shehabeldinkhalid-BioMedecailEng/IOT-C-M/hardware plan.jpeg

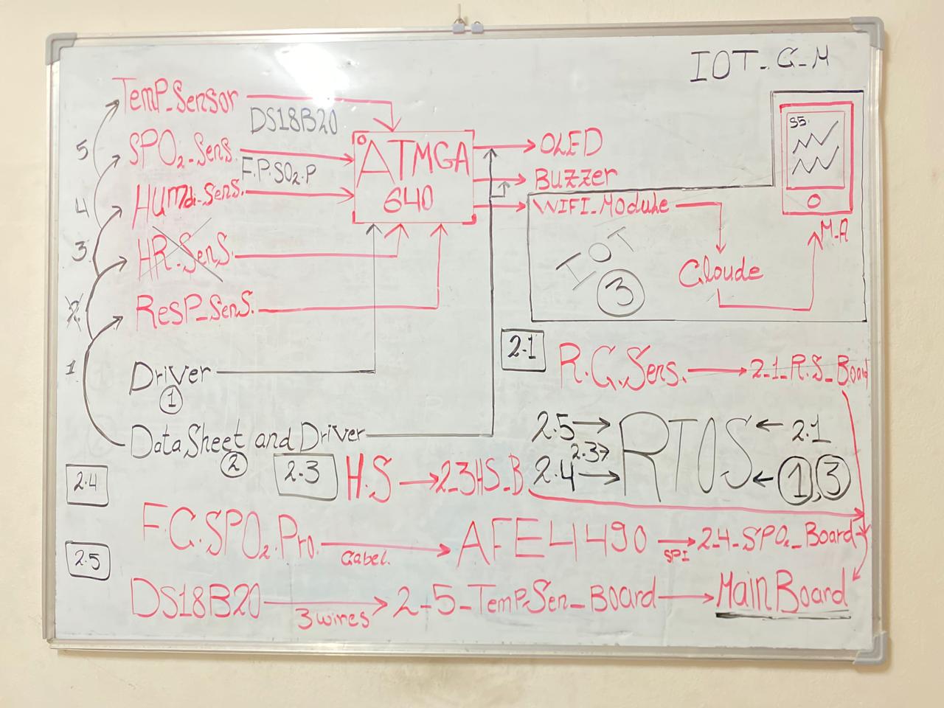
hardware plan.jpeg
