shehabeldinkhalid-BioMedecailEng/IOT-C-M/signal plan.jpeg

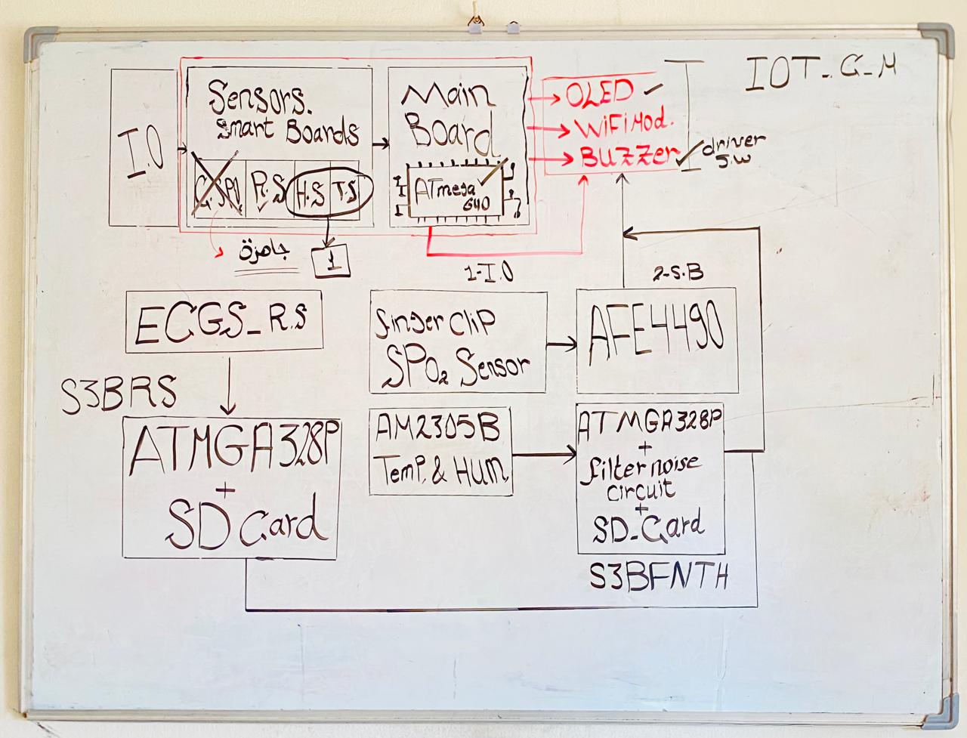
signal plan.jpeg
