shehabeldinkhalid-BioMedecailEng/IOT-C-M/code plan.jpeg

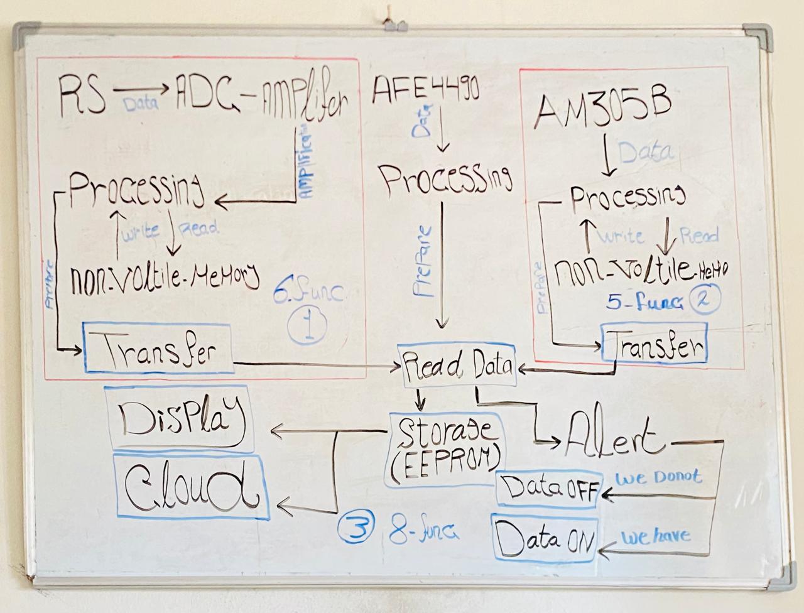
code plan.jpeg
