shehabeldinkhalid-BioMedecailEng/IOT-C-M/da705f88-b7d9-4b37-bf36-8e28f23b1218.webp

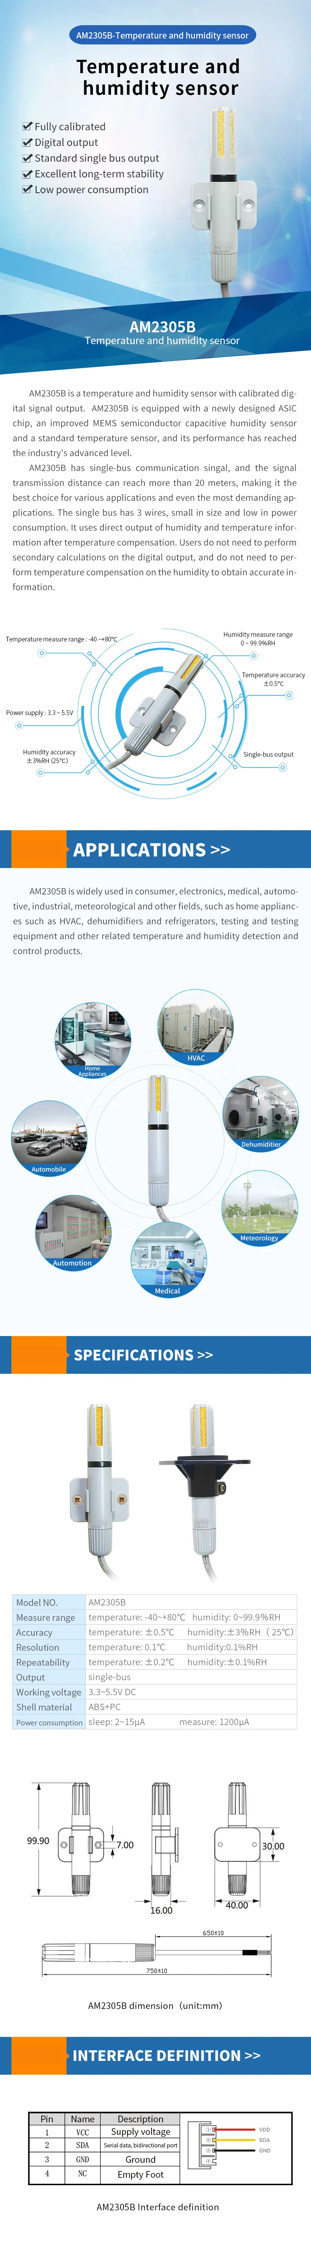
da705f88-b7d9-4b37-bf36-8e28f23b1218.webp
