shehabeldinkhalid-BioMedecailEng/IOT-C-M/Schematic_IOT_C_M_SMART-DEVICE_2026-09-08.pdf

# EX-CLK

## OLED-I2C

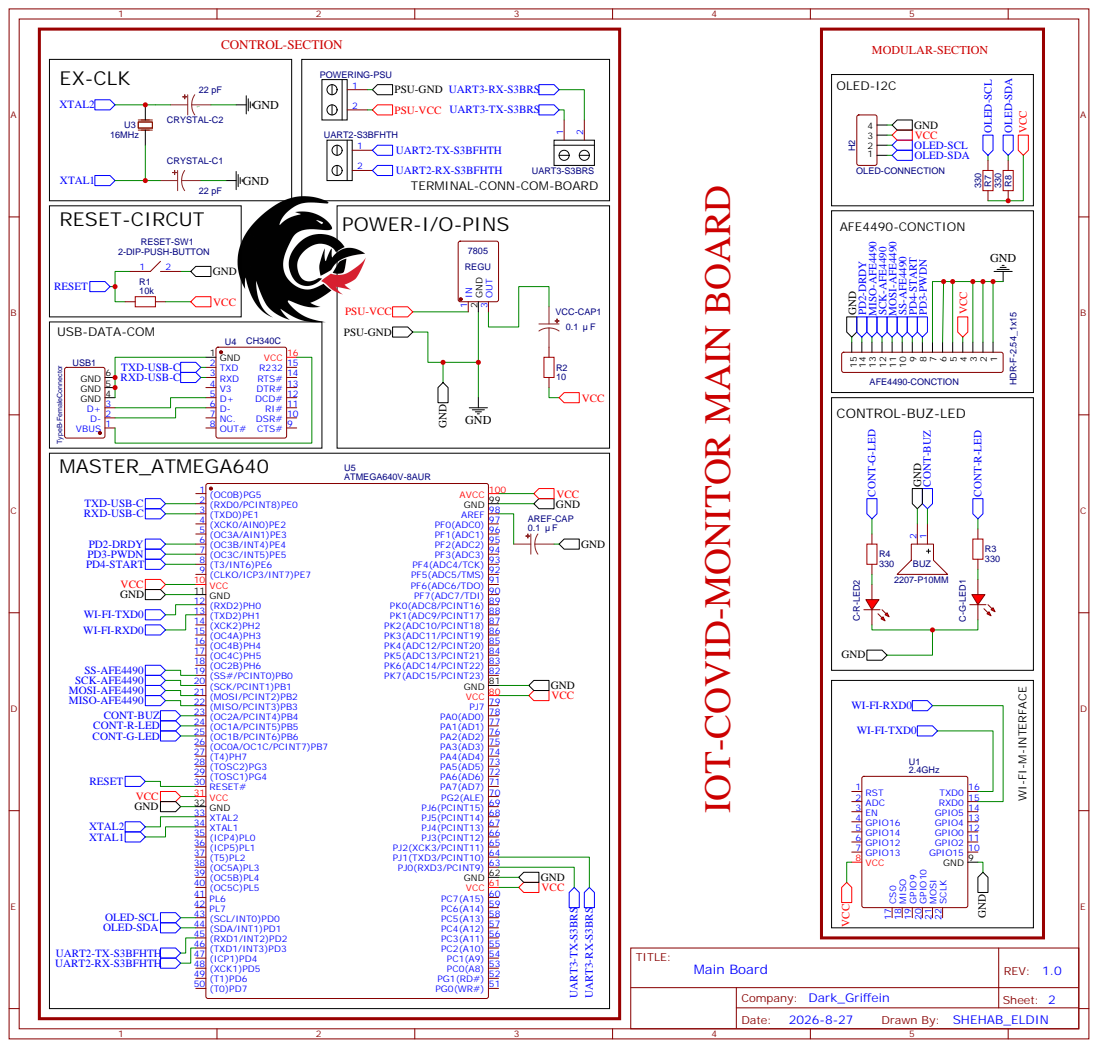
[picture p5: page 1]

UART2-TX-S3BFHTH
UART2-RX-S3BFHTH
TERMINAL-CONN-COM-BOARD
POWER-I/O-PINS

IOT-COVID-MONITOR MAIN BOARD

DSR# 10 RI# 11 DCD# 12 DTR# 13 RTS# 14 R232 15 VCC 16

Atemega328P-AM2305B | POWER-AM2305B

# DS CARD SD\C⁻GND SD\C⁻VCC SD⁻CARD⁻MISO SD⁻CARD⁻MOSI SD⁻CARD⁻SCK SD⁻CARD⁻CS

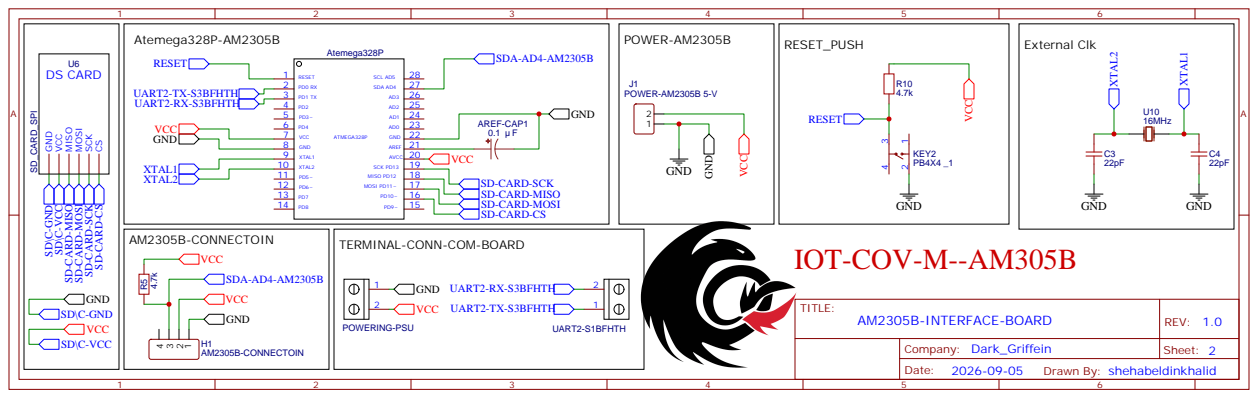
[picture p6: page 2]

TERMINAL-CONN-COM-BOARD

## HX711_IC/RS-INTERFACE BOARD

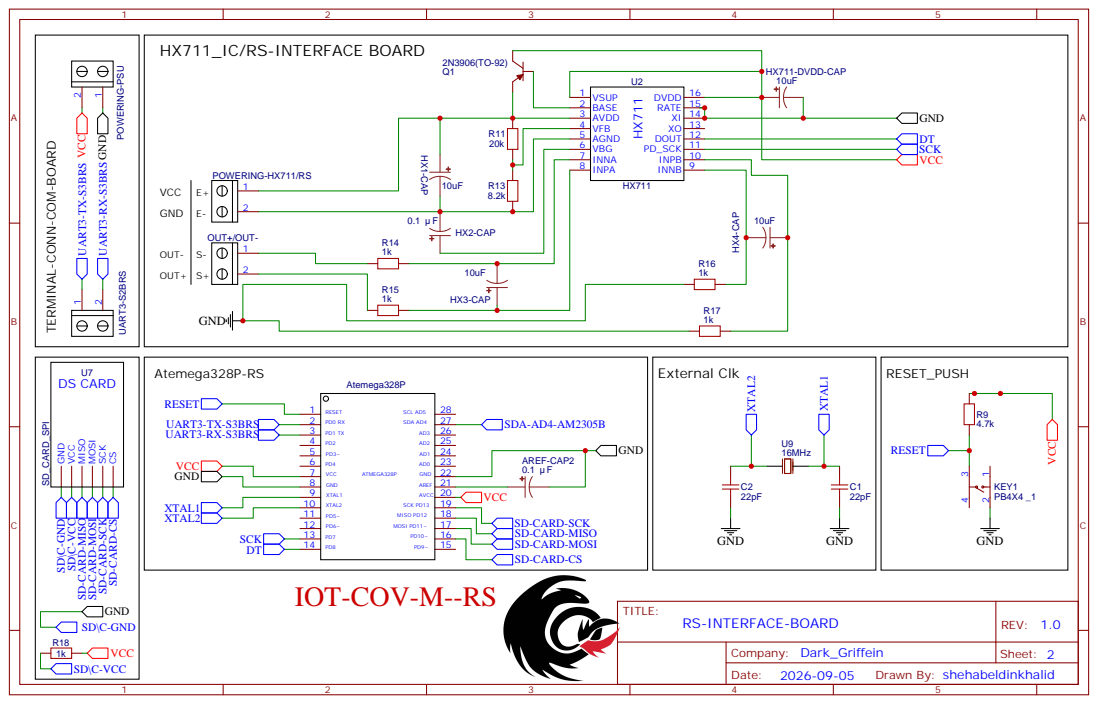
[picture p7: page 3]

INPB 10 PD_SCK 11 DOUT 12 XO 13 XI 14 RATE 15 DVDD 16

TERMINAL-CONN-COM-BOARD

SD\C-GND SD⁻CARD⁻CS SD⁻CARD⁻SCK SD⁻CARD⁻MISO SD⁻CARD⁻MOSI

# POWER SUPPLY

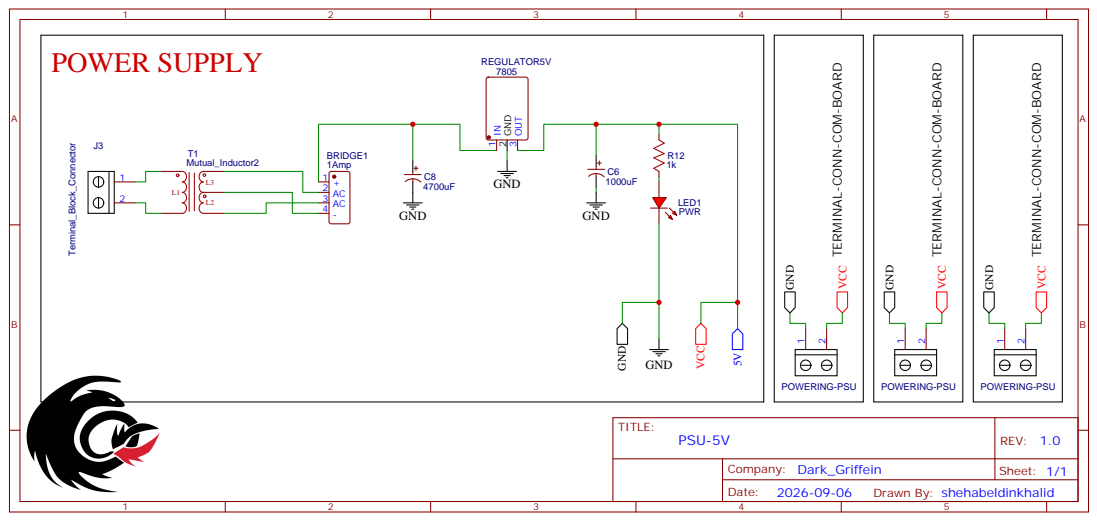
[picture p8: page 4]

TERMINAL-CONN-COM-BOARD

VCC TERMINAL-CONN-COM-BOARD
