shehabeldinkhalid-BioMedecailEng/IOT-C-M/(list of files, drawings)

Other design files:
IOT_C_M.pdsprj
