shehabeldinkhalid-BioMedecailEng/IOT-C-M/SW/ATMEGA640-DRIVERS/HAL/OLED_Config.h

#ifndef OLED_CONFIG_H_
#define OLED_CONFIG_H_

#define OLED_WIDTH              128
#define OLED_HEIGHT             64
#define OLED_PAGES              8

#define OLED_I2C_ADDRESS        0x78

#define OLED_CONTROL_COMMAND    0x00
#define OLED_CONTROL_DATA       0x40

#define OLED_COLUMN_OFFSET      0

#endif /* OLED_CONFIG_H_ */
