shehabeldinkhalid-BioMedecailEng/IOT-C-M/SW/ATMEGA640-DRIVERS/HAL/OLED_Font.c

#include "../../DataTypes.h"

#include "OLED_Font.h"


const OLED_FontChar_t OLED_Font[] =
{
	/* Space */
	{' ', {0x00, 0x00, 0x00, 0x00, 0x00}},

	/* A */
	{'A', {0x7E, 0x11, 0x11, 0x11, 0x7E}},

	/* B */
	{'B', {0x7F, 0x49, 0x49, 0x49, 0x36}},

	/* C */
	{'C', {0x3E, 0x41, 0x41, 0x41, 0x22}},

	/* D */
	{'D', {0x7F, 0x41, 0x41, 0x22, 0x1C}},

	/* E */
	{'E', {0x7F, 0x49, 0x49, 0x49, 0x41}},

	/* F */
	{'F', {0x7F, 0x09, 0x09, 0x09, 0x01}},

	/* G */
	{'G', {0x3E, 0x41, 0x49, 0x49, 0x7A}},

	/* H */
	{'H', {0x7F, 0x08, 0x08, 0x08, 0x7F}},

	/* I */
	{'I', {0x00, 0x41, 0x7F, 0x41, 0x00}},

	/* J */
	{'J', {0x20, 0x40, 0x41, 0x3F, 0x01}},

	/* K */
	{'K', {0x7F, 0x08, 0x14, 0x22, 0x41}},

	/* L */
	{'L', {0x7F, 0x40, 0x40, 0x40, 0x40}},

	/* M */
	{'M', {0x7F, 0x02, 0x0C, 0x02, 0x7F}},

	/* N */
	{'N', {0x7F, 0x04, 0x08, 0x10, 0x7F}},

	/* O */
	{'O', {0x3E, 0x41, 0x41, 0x41, 0x3E}},

	/* P */
	{'P', {0x7F, 0x09, 0x09, 0x09, 0x06}},

	/* Q */
	{'Q', {0x3E, 0x41, 0x51, 0x21, 0x5E}},

	/* R */
	{'R', {0x7F, 0x09, 0x19, 0x29, 0x46}},

	/* S */
	{'S', {0x46, 0x49, 0x49, 0x49, 0x31}},

	/* T */
	{'T', {0x01, 0x01, 0x7F, 0x01, 0x01}},

	/* U */
	{'U', {0x3F, 0x40, 0x40, 0x40, 0x3F}},

	/* V */
	{'V', {0x1F, 0x20, 0x40, 0x20, 0x1F}},

	/* W */
	{'W', {0x7F, 0x20, 0x18, 0x20, 0x7F}},

	/* X */
	{'X', {0x63, 0x14, 0x08, 0x14, 0x63}},

	/* Y */
	{'Y', {0x07, 0x08, 0x70, 0x08, 0x07}},

	/* Z */
	{'Z', {0x61, 0x51, 0x49, 0x45, 0x43}},

	/* 0 */
	{'0', {0x3E, 0x51, 0x49, 0x45, 0x3E}},

	/* 1 */
	{'1', {0x00, 0x42, 0x7F, 0x40, 0x00}},

	/* 2 */
	{'2', {0x62, 0x51, 0x49, 0x49, 0x46}},

	/* 3 */
	{'3', {0x22, 0x41, 0x49, 0x49, 0x36}},

	/* 4 */
	{'4', {0x18, 0x14, 0x12, 0x7F, 0x10}},

	/* 5 */
	{'5', {0x2F, 0x49, 0x49, 0x49, 0x31}},

	/* 6 */
	{'6', {0x3E, 0x49, 0x49, 0x49, 0x32}},

	/* 7 */
	{'7', {0x01, 0x71, 0x09, 0x05, 0x03}},

	/* 8 */
	{'8', {0x36, 0x49, 0x49, 0x49, 0x36}},

	/* 9 */
	{'9', {0x26, 0x49, 0x49, 0x49, 0x3E}},

	/* . */
	{'.', {0x00, 0x60, 0x60, 0x00, 0x00}},

	/* : */
	{':', {0x00, 0x36, 0x36, 0x00, 0x00}},

	/* - */
	{'-', {0x08, 0x08, 0x08, 0x08, 0x08}},

	/* / */
	{'/', {0x20, 0x10, 0x08, 0x04, 0x02}},

	/* % */
	{'%', {0x63, 0x13, 0x08, 0x64, 0x63}}
};


const DT_uint8_t OLED_Font_Size =
sizeof(OLED_Font) / sizeof(OLED_Font[0]);
