shehabeldinkhalid-BioMedecailEng/IOT-C-M/(commit log)

2026-09-13 Create main-board-SW
2026-09-13 Create Drivers
2026-09-13 TIMER AND PULSE WAVE MODULATOR
2026-09-13 OLED I2C ARDUINO 4PINS
2026-09-13 Update and rename all to DRIVERS-SW
